dandz12/ECE411-Practicum-Project/Part_List.txt

Partlist exported from /Users/BumBum/Desktop/T09_LockBox_ver5.0.sch at 11/19/16 9:20 PM

Part  Value            Device           Package        Description			
C1    10uF             CAP0603-CAP      0603-CAP       Capacitor                                                                                                         
C2    100uF            CAP0603-CAP      0603-CAP       Capacitor                                                                                                         
C3    100uF            CAP0603-CAP      0603-CAP       Capacitor                                                                                                         
C4    0.1uF            CAP0603-CAP      0603-CAP       Capacitor                                                                                                         
C5    0.1uF            CAP0603-CAP      0603-CAP       Capacitor                                                                                                         
C6    100uF            CAP0603-CAP      0603-CAP       Capacitor                                                                                                         
D3    1N4004DO-214AC   1N4004DO-214AC   DO-214AC       DIODE                                                                                                             
J1    5.5x2.1mm Barrel POWER_JACKSMD    POWER_JACK_SMD Power Jack                                                 
J2    2Pin-Solenoid    M02PTH           1X02           Header 2                                                                             
J3    3Pin-Servo       M03PTH           1X03           Header 3                                                                                                          
J4    2Pin-Toggle      M02PTH           1X02           Header 2
J5    FEMALE 2x3       M03X2FEMALE      2X3            2x3 .1" header                                             
J6    8Pin-Keypad      M08              1X08_ROUND     Header 8                                                   
J7    7Pin-LCD-Control M07              1X07           Header 7                                                                                                          
J8    5Pin-LCD-Power   M05PTH           1X05           Header 5                                                                                                          
R3    47               RESISTOR0805-RES 0805           Resistor                                                                                                          
R4    1k               RESISTOR0603     0603-RES       Resistor                                                                                                          
R5    10k              RESISTOR0603     0603-RES       Resistor                                                                                                          
R6    8.2K             RESISTOR0603     0603-RES       Resistor                                                                                                          
R7    820              RESISTOR0603     0603-RES       Resistor                                                                                                          
R11   0                RESISTOR0603     0603-RES       Resistor                                                                                                          
R12   0                RESISTOR0603     0603-RES       Resistor                                                                                                          
R13   0                RESISTOR0603     0603-RES       Resistor                                                                                                          
T2    TIP31            TIP31            TO220          NPN Transistor                                                         
TP1   TPPAD1-13        TPPAD1-13        P1-13          Test pad                                                                                                          
TP2   TPPAD1-13        TPPAD1-13        P1-13          Test pad                                                                                                          
TP3   TPPAD1-13        TPPAD1-13        P1-13          Test pad                                                                                                          
TP4   TPPAD1-13        TPPAD1-13        P1-13 in       Test pad                                                                                                          
U1    ATMEGA328P_PDIP  ATMEGA328P_PDIP  DIL28-3        uC used in the Arduino                                                                                            
V_REG LD117AS12TR      LD117AS12TR      SOT223         Positive voltage regulators 1A
