dandz12/ECE411-Practicum-Project/T09_LockBox_Buy-web-list.rtf

0.1 uF cap
http://www.mouser.com/Passive-Components/Capacitors/_/N-5g7r?P=1yzmou6Z1z0wgtu

100 uF cap
http://www.mouser.com/ProductDetail/AVX/F980J107MMAAXE/?qs=OIhlmDO%252boa7CbJsh7hWANA%3d%3d

47 ohms res _ high power
http://www.mouser.com/Passive-Components/Resistors/_/N-5g9n?P=1z0x73sZ1yzbppyZ1yzmou0

10K ohm
http://www.mouser.com/Passive-Components/Resistors/_/N-5g9n?P=1yzmno7Z1z0x6frZ1yzmou6

1k ohm
http://www.mouser.com/Passive-Components/Resistors/Film-Resistors/Thick-Film-Resistors-SMD/_/N-7gz42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

8.2 kohm
http://www.mouser.com/Passive-Components/Resistors/Film-Resistors/Thick-Film-Resistors-SMD/_/N-7gz42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

820 ohm
http://www.mouser.com/Passive-Components/Resistors/Film-Resistors/Thick-Film-Resistors-SMD/_/N-7gz42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

barrel jack
https://www.sparkfun.com/products/12748
