dandz12/ECE411-Practicum-Project/Block Diagram for Useless Lock Box.docx

Block Diagram for Useless Lock Box

LCD

Toggle Switch

Top Door

Open/Close

Funny Thing

Front Door

Open/Close

Motor

Solenoid

KEY PAD

ATmega328P
