dandz12/ECE411-Practicum-Project/Solidworks/pictures/back.png

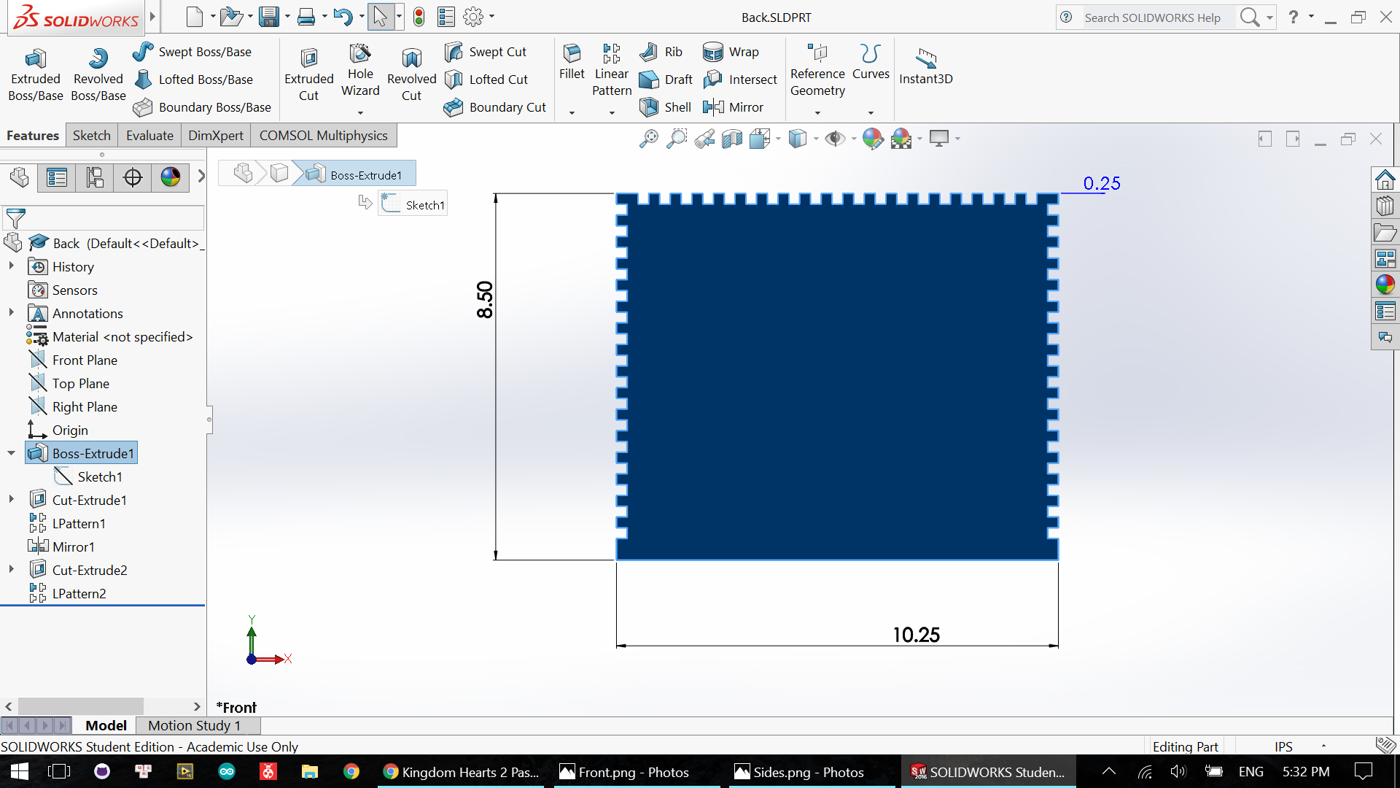
Solidworks/pictures/back.png
