dandz12/ECE411-Practicum-Project/Solidworks/pictures/Bottom.png

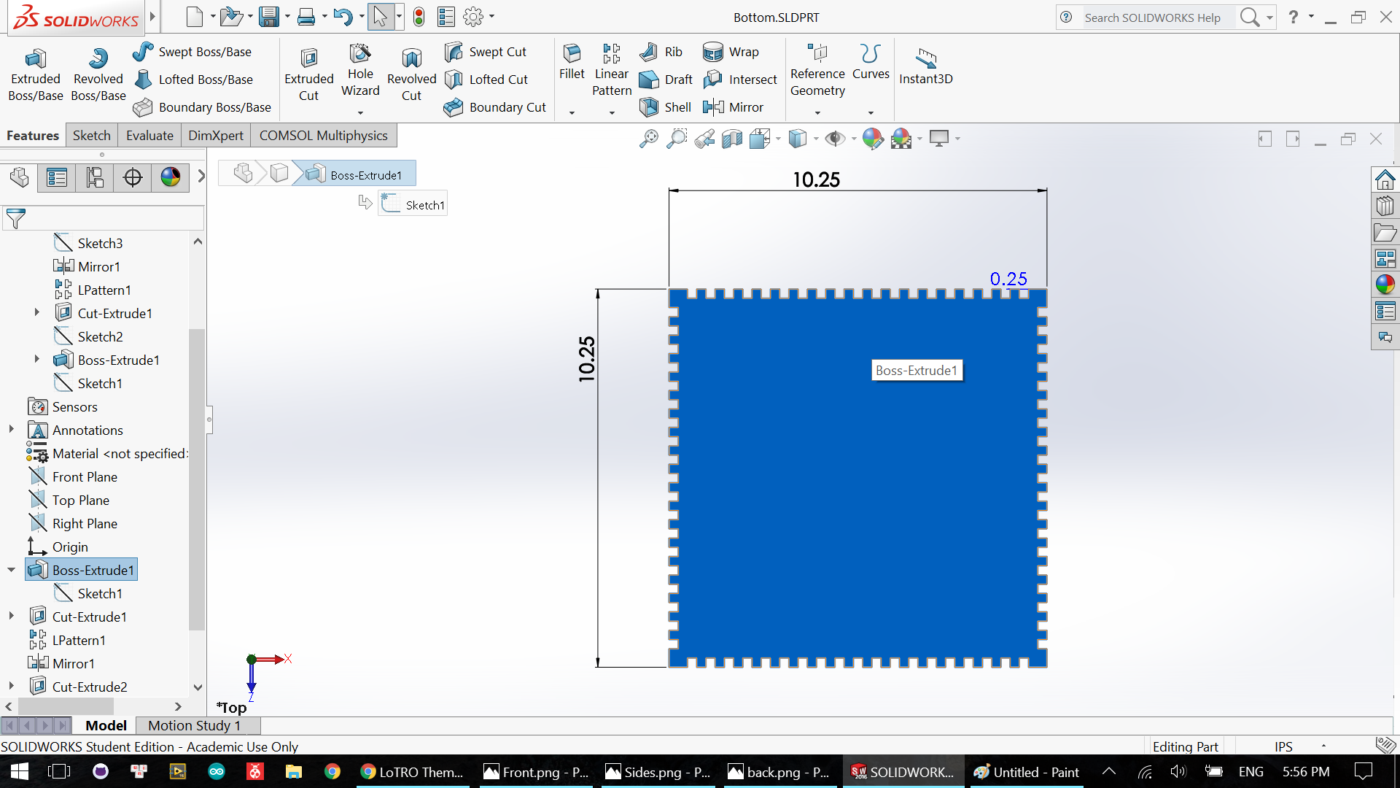
Solidworks/pictures/Bottom.png
