dandz12/ECE411-Practicum-Project/Solidworks/pictures/Front.png

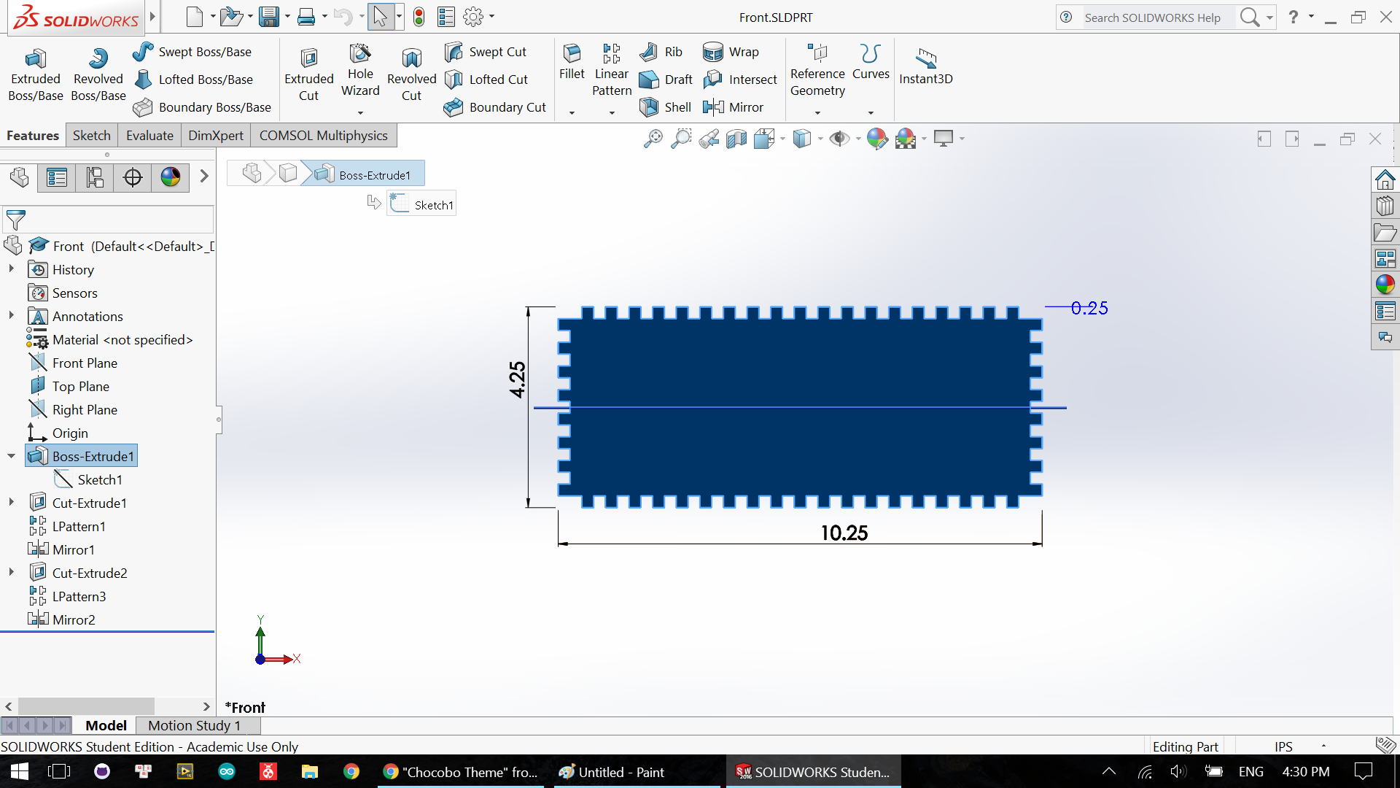
Solidworks/pictures/Front.png
