dandz12/ECE411-Practicum-Project/Solidworks/pictures/full box.png

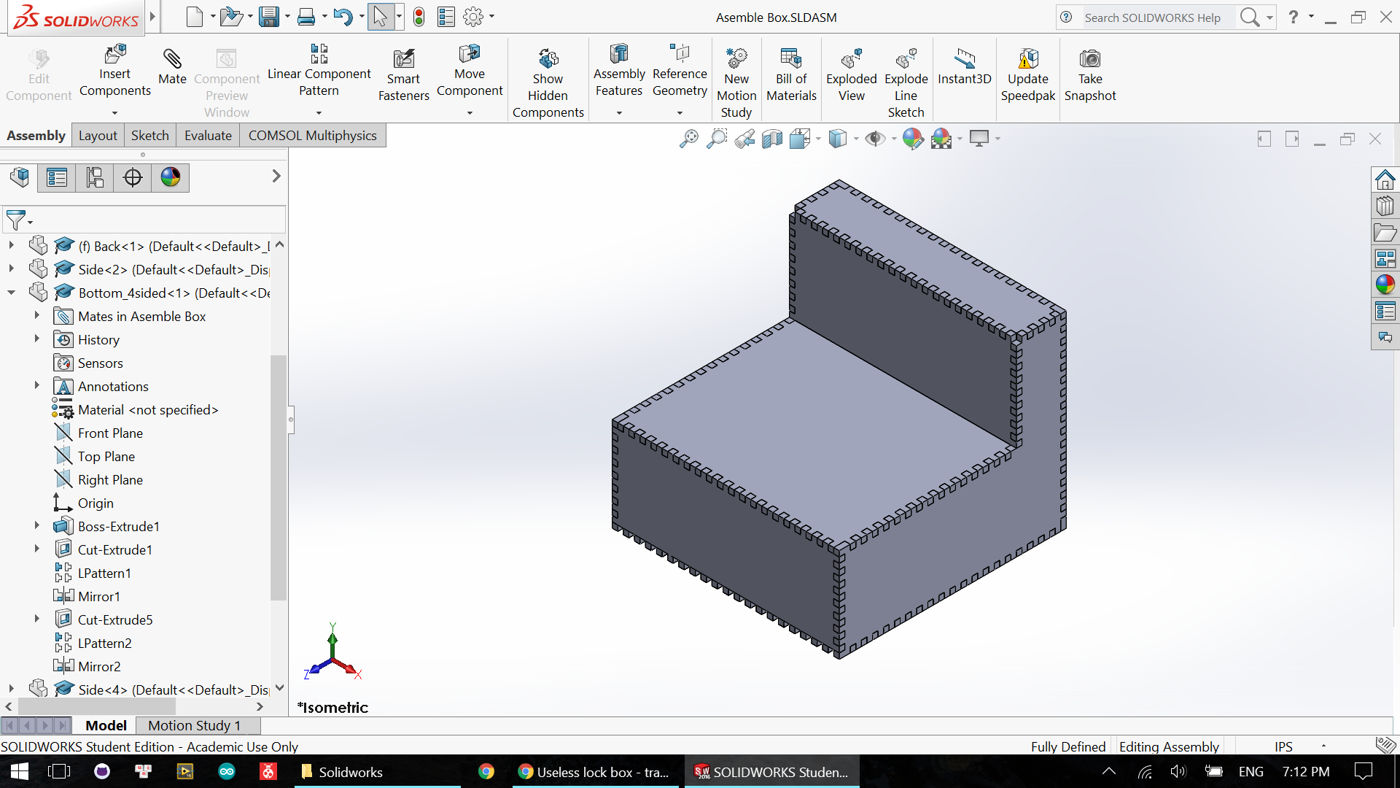
Solidworks/pictures/full box.png
