dandz12/ECE411-Practicum-Project/Solidworks/pictures/Sides.png

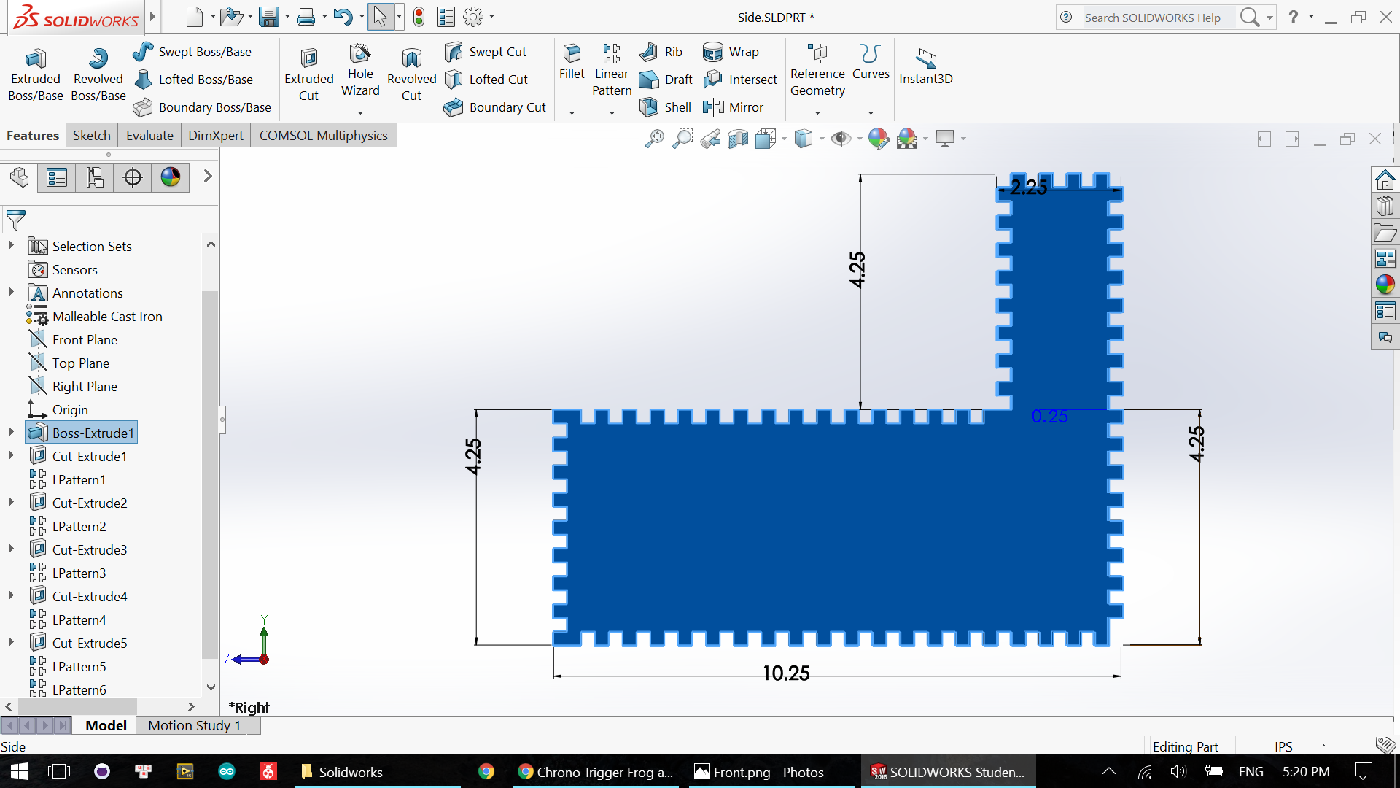
Solidworks/pictures/Sides.png
