dandz12/ECE411-Practicum-Project/Total Unit Cost.xlsx

Part | Value/Name | Quantity | Unit Price (USD) | Column1
Capacitors (SMD) | 0.1 𝜇F | 2 | 0.230 | 0.460
 | 10 𝜇F | 1 | 0.250 | 0.250
 | 100 𝜇F | 3 | 0.382 | 1.146
Resistors (SMD) | 0 𝛺 | 3 | 0.100 | 0.300
 | 47 𝛺 | 1 | 0.058 | 0.058
 | 820 𝛺 | 1 | 0.071 | 0.071
 | 1 k𝛺 | 1 | 0.071 | 0.071
 | 8.2 k𝛺 | 1 | 0.071 | 0.071
 | 10 k𝛺 | 1 | 0.071 | 0.071
NPN Transistor | Tip31 | 1 | 2.000 | 2.000
Diode (SMD) | 1N4004 | 1 | 0.100 | 0.100
Voltage Regulator (SMD) | AMS-1117 | 1 | 0.613 | 0.613
Power Jack (SMD) | 5.5x2.1mm | 1 | 1.500 | 1.500
Microprocessor | ATmega328P | 1 | 5.000 | 5.000
Header |  | 25 | 0.001 | 0.025
Jumper Wire |  | 25 | 0.001 | 0.025
Switch | Rocker Toggle | 1 | 0.742 | 0.742
Solenoid | 4.5V - 0.375A | 1 | 1.998 | 1.998
Keypad | 4x4 matrix | 1 | 3.975 | 3.975
LCD | 16x2 LCD | 1 | 5.900 | 5.900
Servo | TowerPro SG90 | 1 | 2.500 | 2.500
Battery | 9V | 1 | 3.000 | 3.000
Battery holders |  | 2 | 0.995 | 1.990
Battery connector |  | 1 | 0.398 | 0.398
PCB Printing |  | 1 | 10.250 | 10.250
Bamboo Plywood |  | 3 | 10.000 | 30.000
Laser Cutting |  | 1 | 5.000 | 5.000
Metal Sheet |  | 1 | 0.630 | 0.630
Hinges |  | 3 | 0.250 | 0.750
 |  | Total Box Unit Coss |  | 78.893
