dandz12/ECE411-Practicum-Project/Decision Matrix.xlsx

Student | Project Proposal | Sensors |  | Soldering Difficulty | Actuators |  | Soldering Difficulty | Price | Size | Creative | Complexity | Total
Daniel | Sequence controlled alarm clock | 1 | Buttons | 3 | 1 | LCD Screen | 3 | 3 | 3 | 1 | 2 | 19
 |  | 2 |  |  | 2 | Speaker | 2
 |  | 3 |  |  | 3
Dwayne | Personal CO2 detector | 1 | C02 sensor | 5 | 1 | Alarm/Buzzer | 1 | 3 | 2 | 3 | 4 | 36
 |  | 2 |  |  | 2 | Display | 3
 |  | 3 |  |  | 3
Ha | Rain alarm system | 1 | Humidity sensor | 4 | 1 | LCD Screen | 3 | 3 | 3 | 2 | 3 | 25
 |  | 2 | Temperature sensor | 4 | 2 | Alarm | 1
 |  | 3 |  |  | 3
Thanh | Useless Lock Box | 1 | Number Pad Buttons | 3 | 1 | LCD Screen | 3 | 3 | 4 | 4 | 3 | 39
 |  | 2 |  |  | 2 | Speaker | 2
 |  | 3 |  |  | 3 | Motors | 2
 |  |  | Scale: | Easy-Difficult |  |  | Easy-Difficult | Cheap-Expensive | Small-Large | Not-Very | Not-Very
 |  |  | Weight: | 1 |  |  | 1 | 2 | 2 | 5 | 5
