dandz12/ECE411-Practicum-Project/Box Solidwork/LockBox.SLDASM

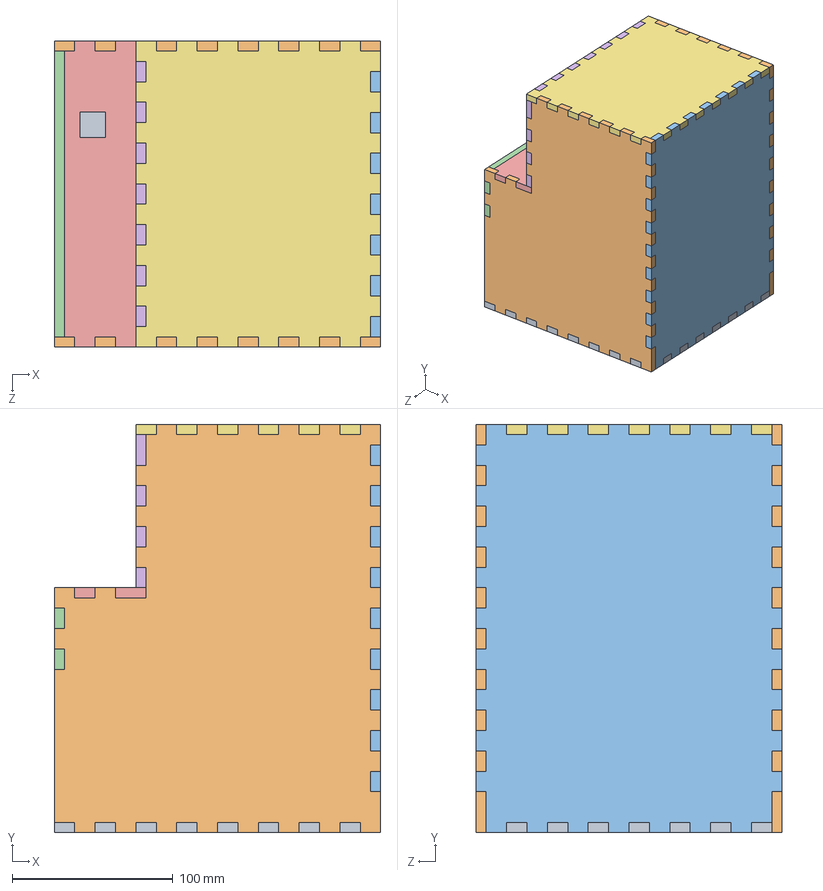
[picture p26: CAD file, 2016-12-08]
Box Solidwork/LockBox.SLDASM
203.2 x 254.0 x 190.5 mm
Bottom
Side x 2
Back
Front1
Top1
Front2
Top2
Door
