dandz12/ECE411-Practicum-Project/Solidworks/Asemble Box.SLDASM

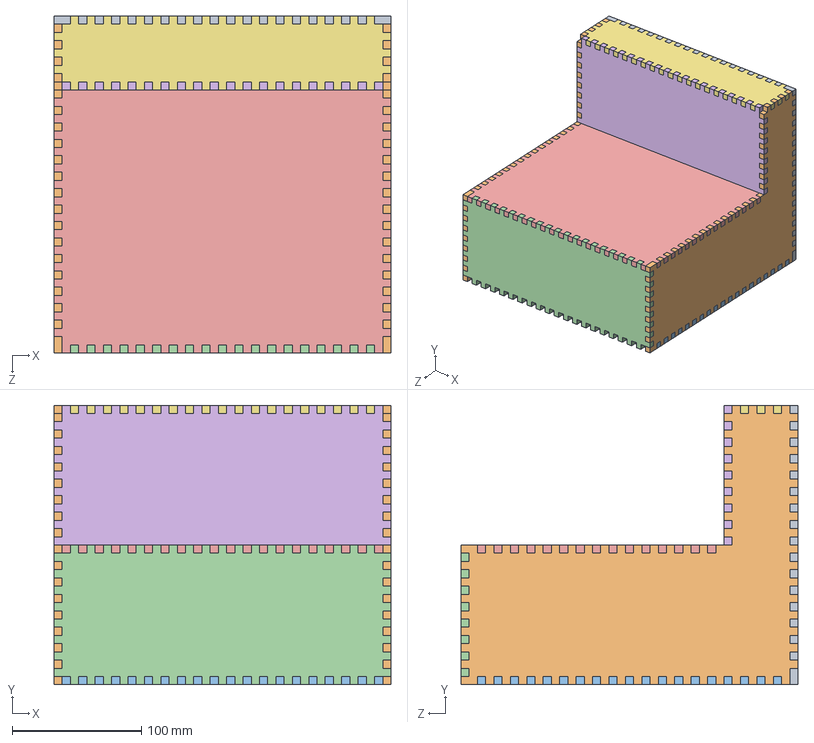
[picture p27: CAD file, 2016-11-25]
Solidworks/Asemble Box.SLDASM
260.4 x 215.9 x 260.4 mm
Back
Side x 2
Bottom_4sided
Front
Top_big
Front_topversion
Top-small
