dandz12/ECE411-Practicum-Project/Box Solidwork/Top2.SLDPRT

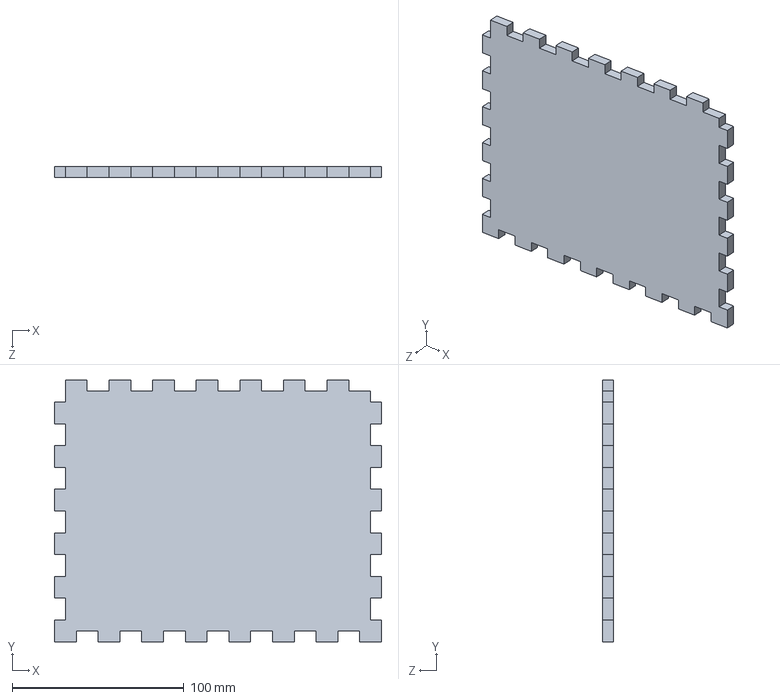
[picture p28: CAD file, 2016-12-08]
Box Solidwork/Top2.SLDPRT
190.5 x 152.4 x 6.35 mm
