dandz12/ECE411-Practicum-Project/Solidworks/Back.SLDPRT

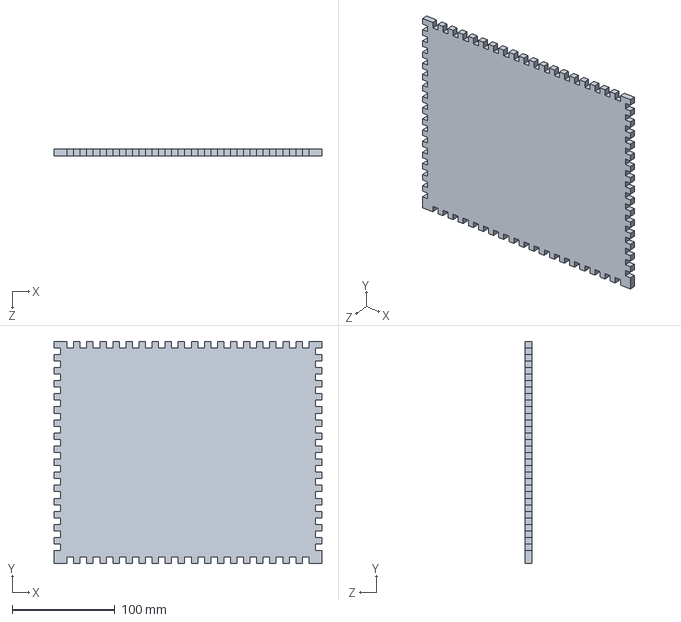
[picture p29: CAD file, 2016-11-25]
Solidworks/Back.SLDPRT
260.3 x 215.9 x 6.35 mm
