dandz12/ECE411-Practicum-Project/Box Solidwork/Front2.SLDPRT

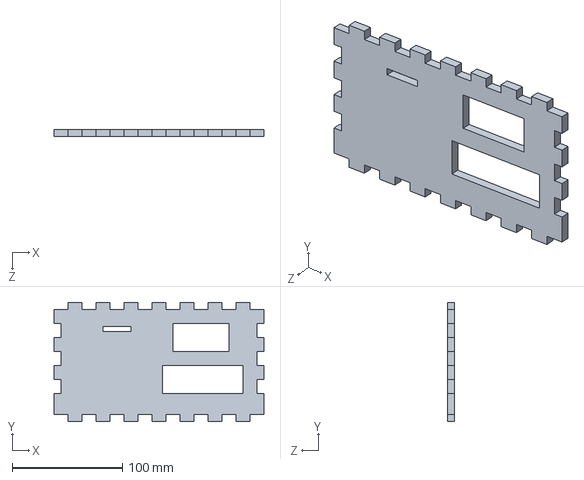
[picture p30: CAD file, 2016-12-08]
Box Solidwork/Front2.SLDPRT
190.5 x 108.0 x 6.35 mm
