dandz12/ECE411-Practicum-Project/Solidworks/Front.SLDPRT

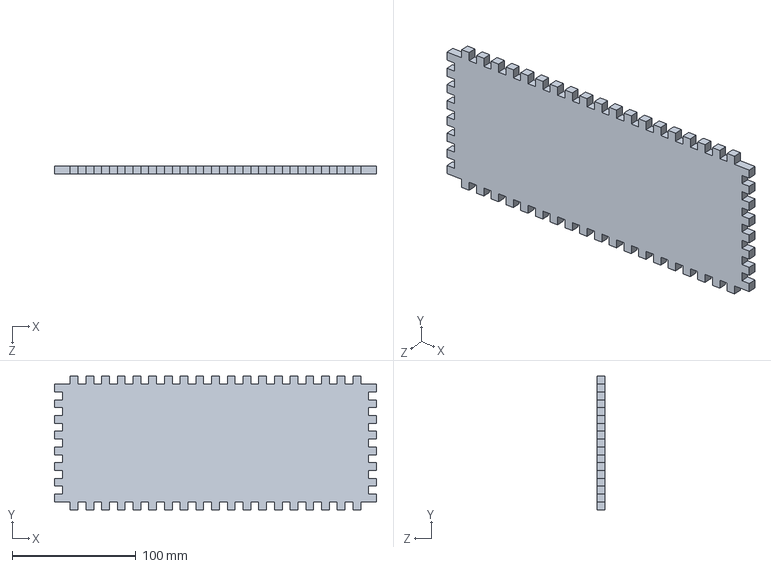
[picture p31: CAD file, 2016-11-25]
Solidworks/Front.SLDPRT
260.3 x 108.0 x 6.35 mm
