dandz12/ECE411-Practicum-Project/Box Solidwork/Back.SLDPRT

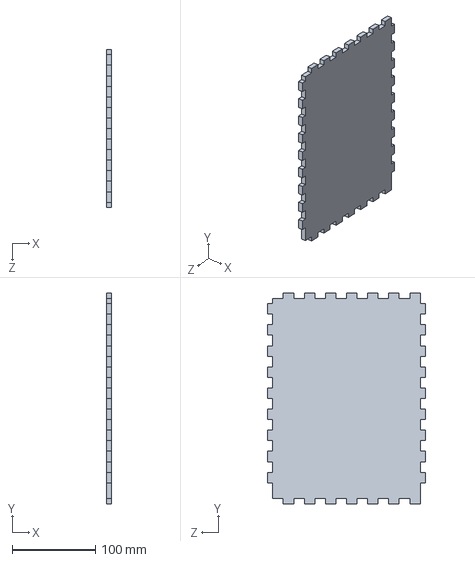
[picture p32: CAD file, 2016-12-08]
Box Solidwork/Back.SLDPRT
6.35 x 254.0 x 190.5 mm
