dandz12/ECE411-Practicum-Project/Solidworks/Top-small.SLDPRT

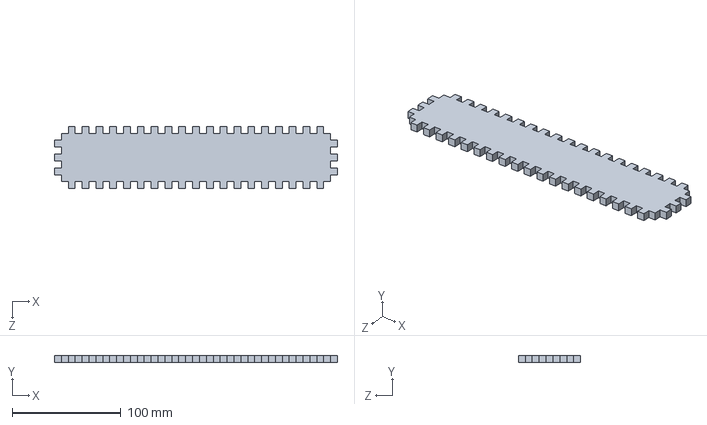
[picture p33: CAD file, 2016-11-25]
Solidworks/Top-small.SLDPRT
260.3 x 6.35 x 57.1 mm
