dandz12/ECE411-Practicum-Project/Box Solidwork/Door.SLDPRT

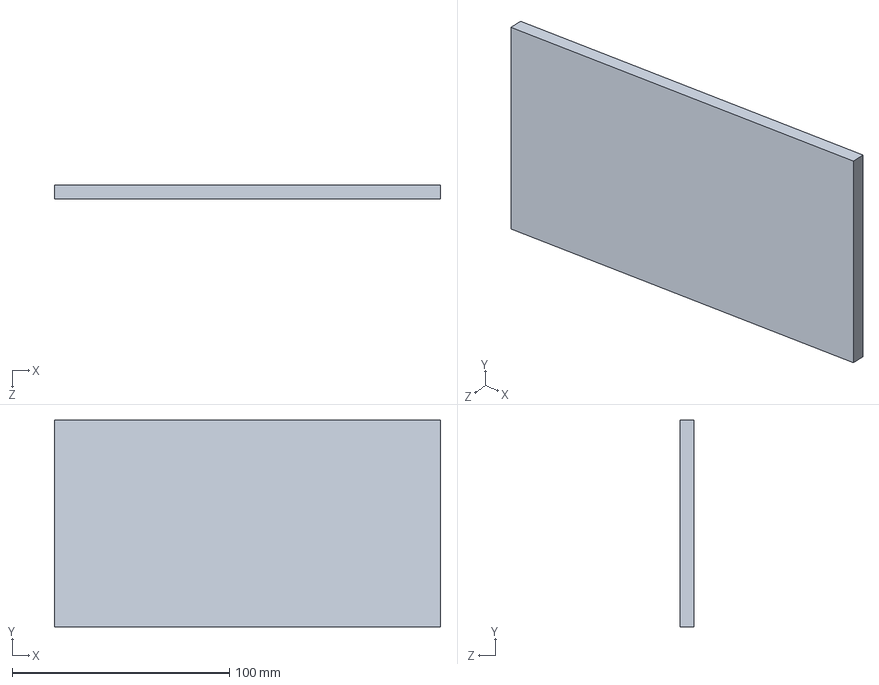
[picture p34: CAD file, 2016-12-08]
Box Solidwork/Door.SLDPRT
177.8 x 95.2 x 6.35 mm
