dandz12/ECE411-Practicum-Project/Solidworks/Front_topversion.SLDPRT

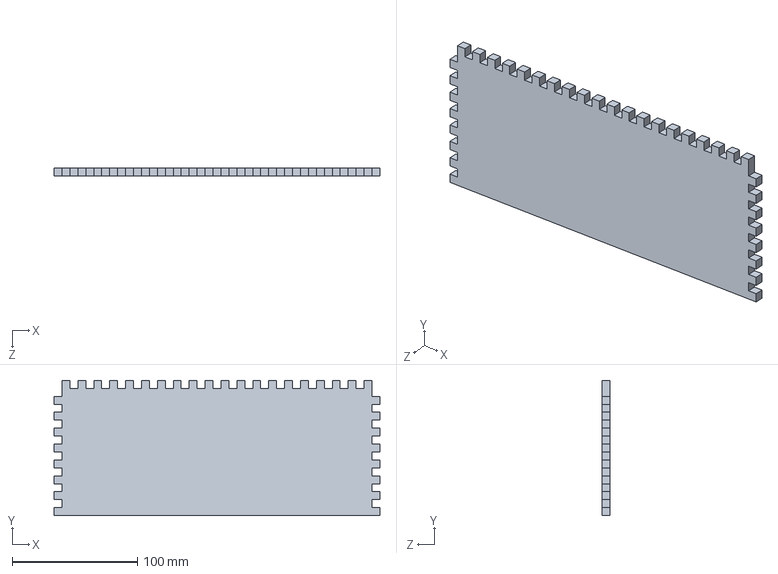
[picture p35: CAD file, 2016-11-25]
Solidworks/Front_topversion.SLDPRT
260.3 x 108.0 x 6.35 mm
