dandz12/ECE411-Practicum-Project/Solidworks/Side.SLDPRT

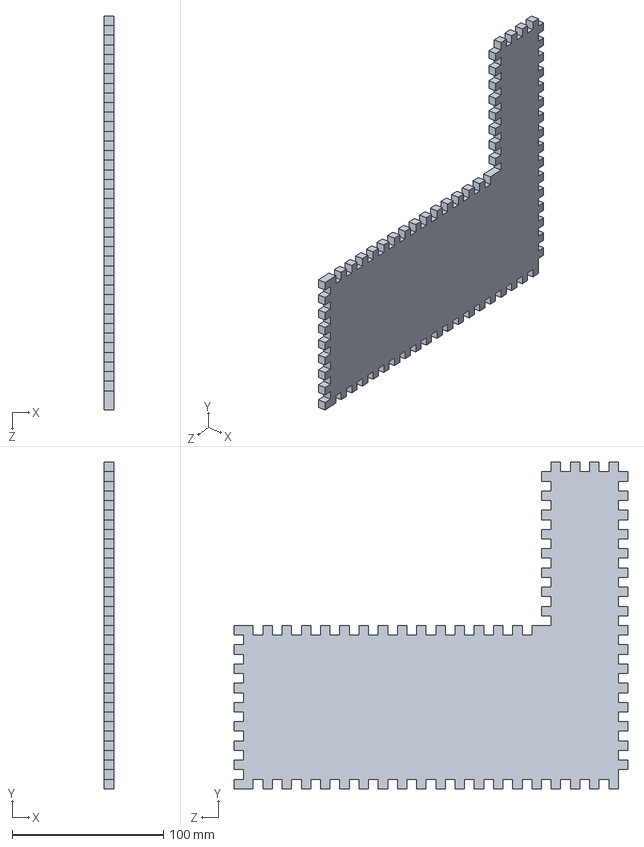
[picture p36: CAD file, 2016-11-25]
Solidworks/Side.SLDPRT
6.35 x 215.9 x 260.3 mm
