dandz12/ECE411-Practicum-Project/Solidworks/Bottom.SLDPRT

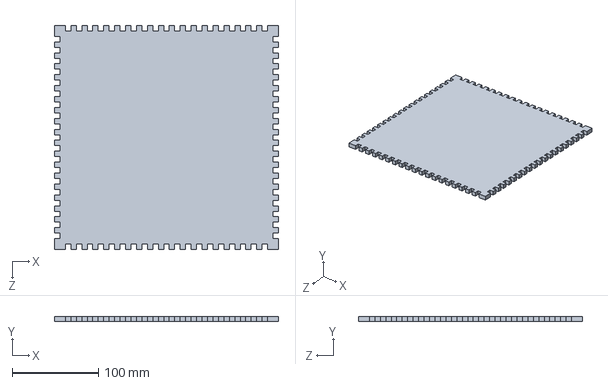
[picture p38: CAD file, 2016-11-25]
Solidworks/Bottom.SLDPRT
260.3 x 6.35 x 260.3 mm
