dandz12/ECE411-Practicum-Project/Solidworks/Top_big.SLDPRT

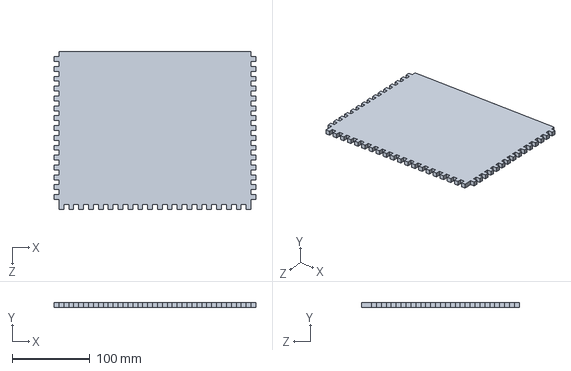
[picture p39: CAD file, 2016-11-25]
Solidworks/Top_big.SLDPRT
260.3 x 6.35 x 203.2 mm
