dandz12/ECE411-Practicum-Project/Box Solidwork/Side.SLDPRT

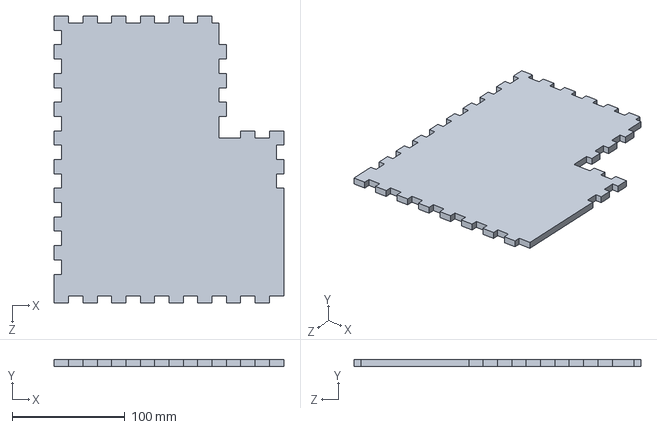
[picture p40: CAD file, 2016-12-08]
Box Solidwork/Side.SLDPRT
203.2 x 6.35 x 254.0 mm
