dandz12/ECE411-Practicum-Project/Box Solidwork/Bottom.SLDPRT

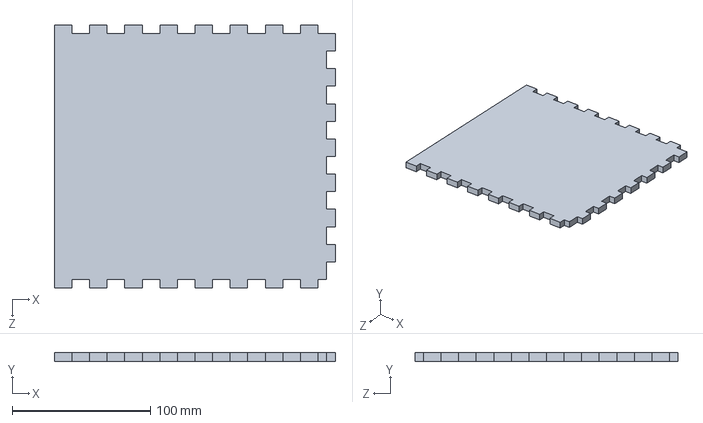
[picture p41: CAD file, 2016-12-08]
Box Solidwork/Bottom.SLDPRT
203.2 x 6.35 x 190.5 mm
