dandz12/ECE411-Practicum-Project/Box Solidwork/Front1.SLDPRT

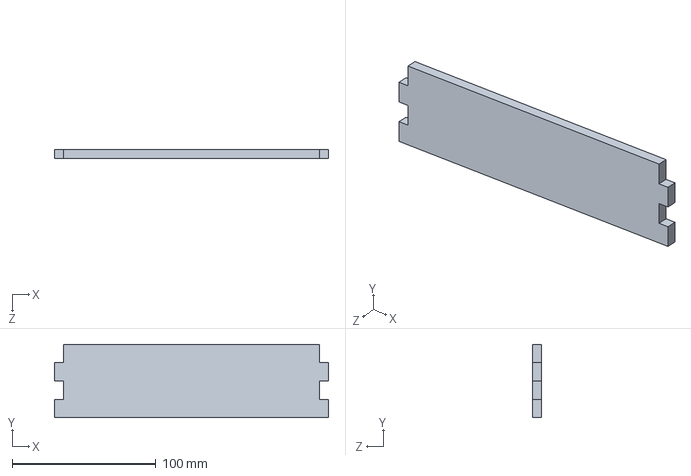
[picture p42: CAD file, 2016-12-08]
Box Solidwork/Front1.SLDPRT
190.5 x 50.8 x 6.35 mm
