dandz12/ECE411-Practicum-Project/(list of files, cad)

Other CAD files:
Solidworks/Bottom_4sided.SLDPRT
Box Solidwork/Bottom_Top2_Door.SLDDRW
Box Solidwork/Side_Back.SLDDRW
Box Solidwork/Side_Front1-2_Top1.SLDDRW
Box Solidwork/Top1 - Copy.SLDPRT
