dandz12/ECE411-Practicum-Project/Test Plan.docx

Team 09 – Useless Lock Box

Test Plan

Rev 1.0

11-24-2016

REVISION HISTORY

Date | Version | Description | Author
11/21/2016 | 1.0 | Initial release | Team 9
11/24/2016 | 2.0 | Test Plan Revision Meeting | Team 9

# 1. Objective

This document describes the test plan for the Useless Lock Box, Team 09’s practicum project in ECE411. This test plan document supports the following objectives:

- Identify project information about what should be tested.
- List of the recommended test equipment
- Identify the required human resources
- Provide an estimate of the test efforts

# 2. Design documentation (see appendix)

  2.1. Description, Rev 1.0
  2.2. PDS – Product Design Specification, Rev 2.0
  2.3. Block Diagram, Rev 2.0
  2.4. Schematic, Rev 5.0
  2.5. Board Layout, Rev 5.0
  2.6. BOM – Bill of Materials

# 3. Test Equipment

  3.1. Computer
  3.2. AVR Dragon or other development board
  3.3. Power Supply
  3.4. VOM – Volt Ohm Meter
  3.5. Oscilloscope
  3.6. 2 prototypes of the Useless Lock Box

# 4. Human resources

The test team consists of 4 members. A member must be a senior student majoring in Electrical Engineering. Expected time length is 1.5 weeks (10 hours per weeks) for each team member.

Below is the detail staffing. Notice that each member should collaborate which others to fully understand test plan as a ECE411’s deliverable.

Role | HR | Responsibility
Test manager | Dwayne | Provide direction for the team Manage reports
Implementer | Thanh | Create/build necessary test unit
Code tester | Daniel | Test code for microcontroller
Mechanical tester | Ha | Test toggle switch and lock mechanism

# 5. System Tests

  5.1. Unit/Module Tests

A complete test of a module’s functionality to ensure desired results.

    5.1.1. Servo
    5.1.2. Keypad
    5.1.3. Solenoid
    5.1.4. LCD Screen
    5.1.5. Switch
  5.2. Integration Tests

Complete testing of paths between modules to ensure they operate correctly together.

    5.2.1. Possible system paths
      5.2.1.1. Switch to LCD
      5.2.1.2. LCD to Keypad
      5.2.1.3. Correct Code Entered
        5.2.1.3.1. Keypad to Solenoid
        5.2.1.3.2. Keypad to Servo
        5.2.1.3.3. Servo to LCD
      5.2.1.4. Administration Code Entered
        5.2.1.4.1. Keypad to LCD
        5.2.1.4.2. LCD to Keypad
        5.2.1.4.3. Keypad to Servo
        5.2.1.4.4. Servo to LCD
      5.2.1.5. Incorrect Code Entered
        5.2.1.5.1. Keypad to Servo
        5.2.1.5.2. Servo to LCD
  5.3. Acceptance Test – Appendix A

Check to ensure the end result meets the conditions the customer defined in the PDS.

    5.3.1. Functionality
    5.3.2. Economic Goals
    5.3.3. Aesthetics
    5.3.4. Operational Physical Environment
    5.3.5. Size/Weight
  5.4. Stress Tests

Check behavior when extreme circumstances arise.

    5.4.1. Power Removed
    5.4.2. See User Error Tests
  5.5. Use Testing

Check typical user interaction.

    5.5.1. Flip Switch
      5.5.1.1. Correct Code
      5.5.1.2. Administration Code
      5.5.1.3. Incorrect Code
  5.6. Error Testing

Test for error conditions originating from non-prescribed user behavior and system bugs.

    5.6.1. User Error
      5.6.1.1. Double Key Press
      5.6.1.2. Obstruction of Arm Path
      5.6.1.3. Quick On Then Off of Switch
      5.6.1.4. 4 + n Keys Pressed
      5.6.1.5. 4 – n Keys Pressed
    5.6.2. System Errors
      5.6.2.1. LCD Timing
      5.6.2.2. PWM Timing
      5.6.2.3. Switch Doesn’t Get Flipped

# 6. Appendix A

Design documentation can be found at: https://github.com/dandz12/ECE411-Practicum-Project

Test Cases
