dandz12/ECE411-Practicum-Project/Box Files For Laser Cutting/Bottom_Top2_Door.PDF

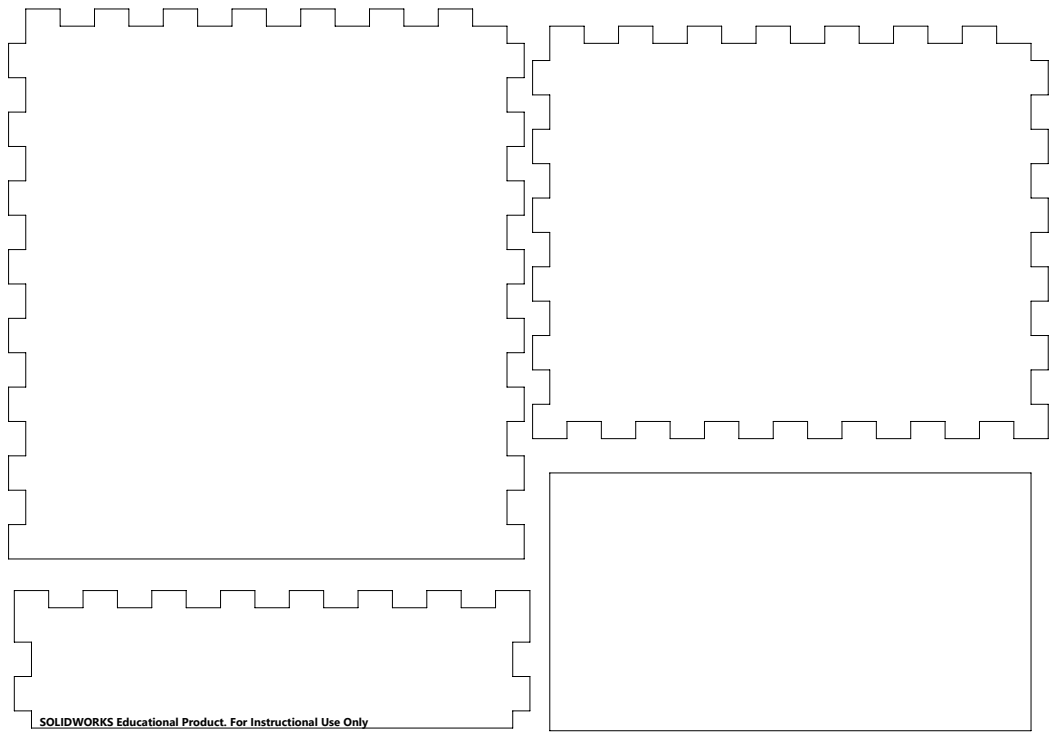
[picture p43: page 1]

SOLIDWORKS Educational Product. For Instructional Use Only
