dandz12/ECE411-Practicum-Project/Box Files For Laser Cutting/Side_Back.PDF

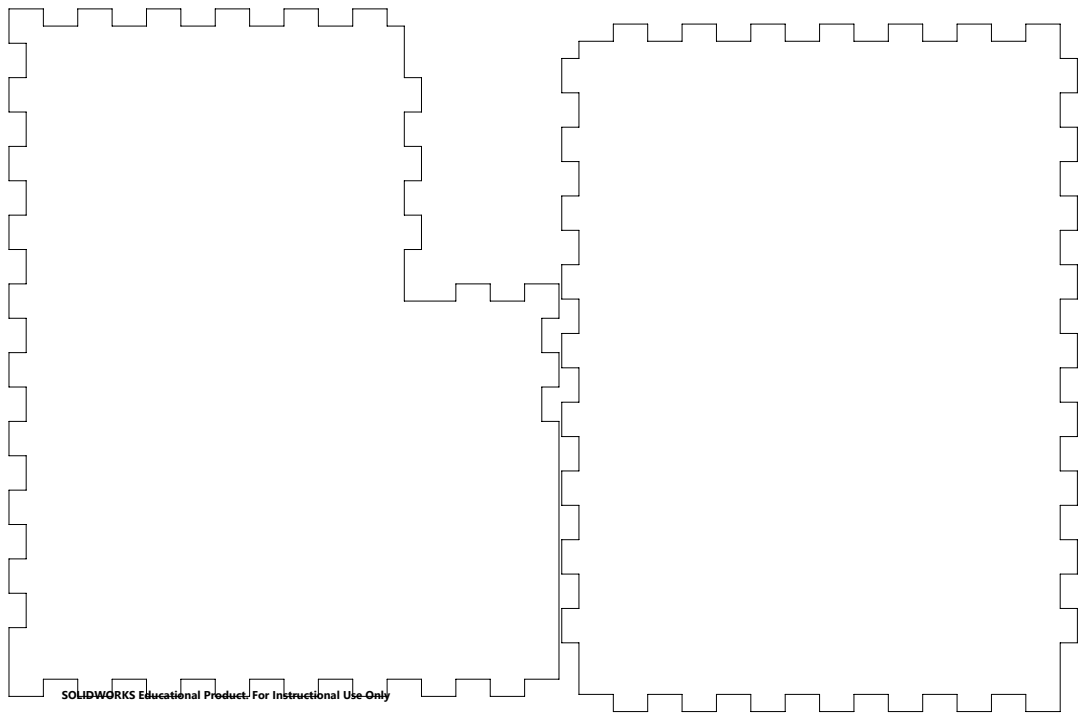
[picture p44: page 1]

SOLIDWORKS Educational Product. For Instructional Use Only
