dandz12/ECE411-Practicum-Project/Box Files For Laser Cutting/Side_Front1-2_Top1.PDF

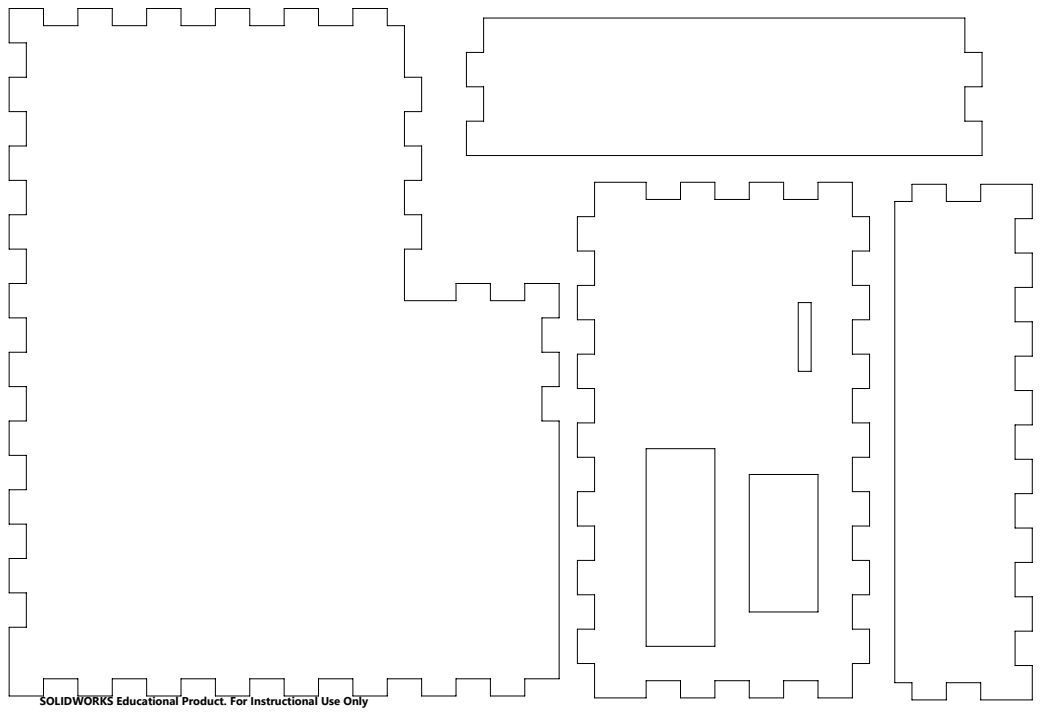
[picture p45: page 1]

SOLIDWORKS Educational Product. For Instructional Use Only
