dandz12/ECE411-Practicum-Project/T09_LockBox_ver5.0.brd

## EAGLE design T09_LockBox_ver5.0.brd (2016-11-17)

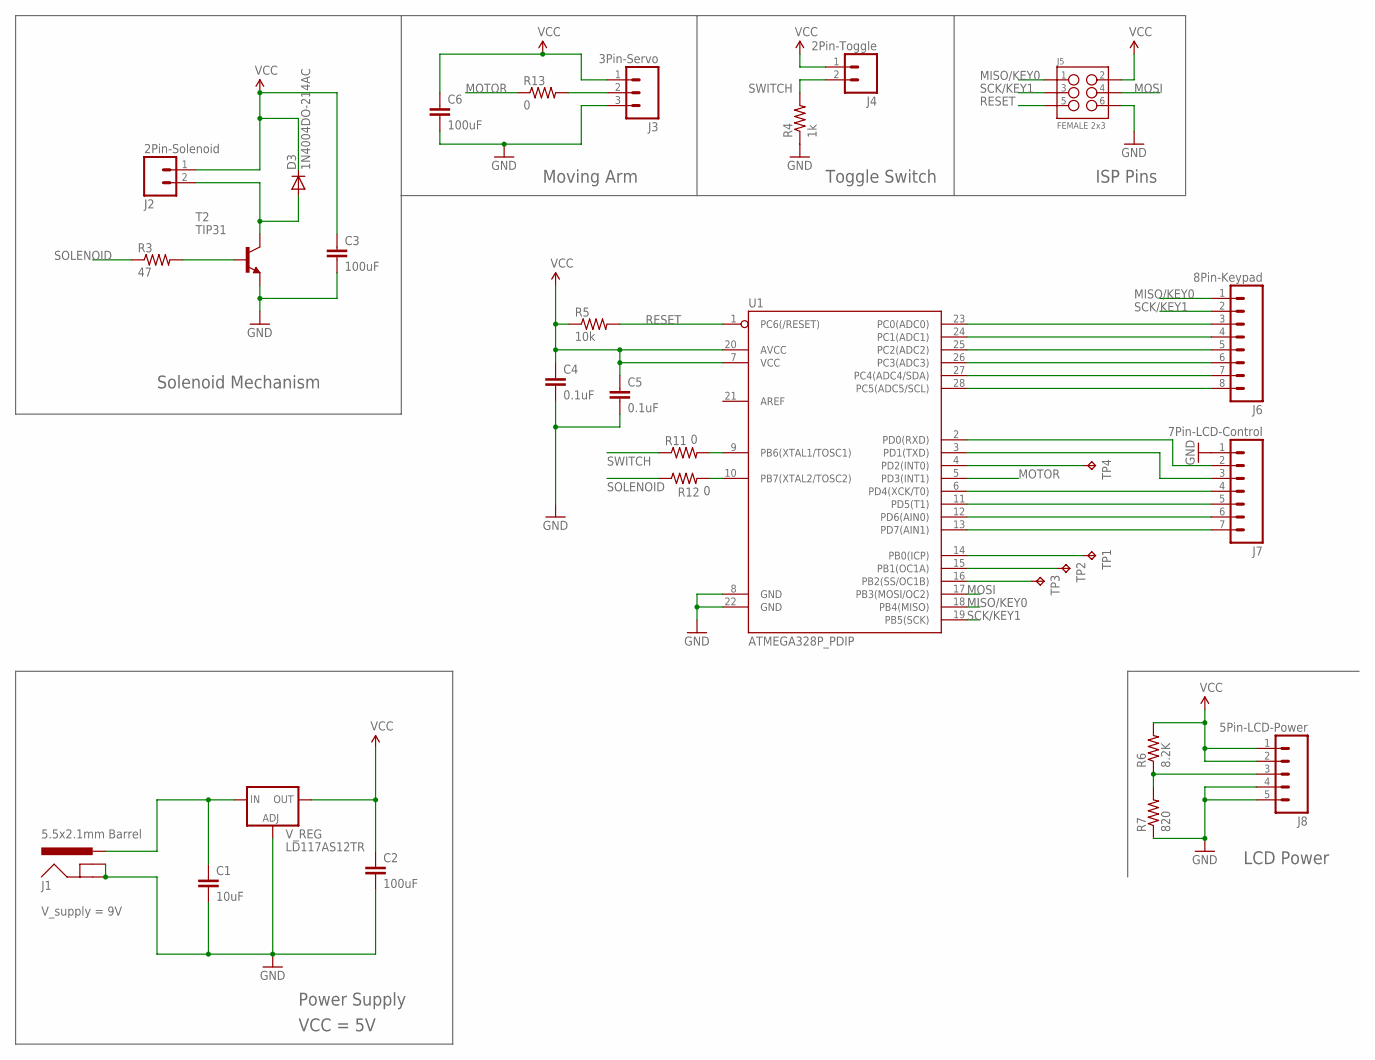
[picture p46: schematic T09_LockBox_ver5.0.sch]

Parts:
C1: 10uF; 0603-CAP
C2, C3, C6: 100uF; 0603-CAP
C4, C5: 0.1uF; 0603-CAP
D3: 1N4004DO-214AC; DO-214AC
J1: 5.5x2.1mm Barrel; POWER_JACK_SMD
J2: 2Pin-Solenoid; 1X02
J3: 3Pin-Servo; 1X03
J4: 2Pin-Toggle; 1X02
J5: FEMALE 2x3; 2X3
J6: 8Pin-Keypad; 1X08_ROUND
J7: 7Pin-LCD-Control; 1X07
J8: 5Pin-LCD-Power; 1X05
R3: 47; 0805
R4: 1k; 0603-RES
R5: 10k; 0603-RES
R6: 8.2K; 0603-RES
R7: 820; 0603-RES
R11, R12, R13: 0; 0603-RES
T2: TIP31; TO220
TP1, TP2, TP3, TP4: TPPAD1-13; P1-13
U1: ATMEGA328P_PDIP; DIL28-3
V_REG: LD117AS12TR; SOT223

Connections:
GND: C1.2, C2.2, C3.2, C4.2, C5.2, C6.2, J1.GND (GNDBREAK), J1.P$4 (GND), J3.3, J5.6, J7.1, J8.4, J8.5, R4.1, R7.1, T2.3 (E), U1.8 (GND), U1.22 (GND), V_REG.1 (ADJ)
MISO/KEY0: J5.1, J6.1, U1.18 (PB4(MISO))
MOSI: J5.4, U1.17 (PB3(MOSI/OC2))
MOTOR: R13.1, U1.5 (PD3(INT1))
unnamed: D3.A, J2.2, T2.2 (C)
unnamed: J8.3, R6.1, R7.2
unnamed: R3.2, T2.1 (B)
unnamed: J7.2, U1.2 (PD0(RXD))
unnamed: R11.2, U1.9 (PB6(XTAL1/TOSC1))
unnamed: R12.2, U1.10 (PB7(XTAL2/TOSC2))
unnamed: J3.2, R13.2
unnamed: J7.3, U1.3 (PD1(TXD))
unnamed: J7.4, U1.6 (PD4(XCK/T0))
unnamed: J7.5, U1.11 (PD5(T1))
unnamed: J7.6, U1.12 (PD6(AIN0))
unnamed: J7.7, U1.13 (PD7(AIN1))
unnamed: J6.3, U1.23 (PC0(ADC0))
unnamed: J6.4, U1.24 (PC1(ADC1))
unnamed: J6.5, U1.25 (PC2(ADC2))
unnamed: J6.6, U1.26 (PC3(ADC3))
unnamed: J6.7, U1.27 (PC4(ADC4/SDA))
unnamed: J6.8, U1.28 (PC5(ADC5/SCL))
unnamed: TP4.TP, U1.4 (PD2(INT0))
unnamed: TP1.TP, U1.14 (PB0(ICP))
unnamed: TP2.TP, U1.15 (PB1(OC1A))
unnamed: TP3.TP, U1.16 (PB2(SS/OC1B))
RESET: J5.5, R5.2, U1.1 (PC6(/RESET))
SCK/KEY1: J5.3, J6.2, U1.19 (PB5(SCK))
SOLENOID: R3.1, R12.1
SWITCH: J4.2, R4.2, R11.1
VCC: C2.1, C3.1, C4.1, C5.1, C6.1, D3.C, J2.1, J3.1, J4.1, J5.2, J8.1, J8.2, R5.1, R6.2, U1.7 (VCC), U1.20 (AVCC), V_REG.4 (OUT)
VIN: C1.1, J1.VIN0 (PWR), V_REG.3 (IN)

Notes on the sheet:
VCC = 5V
Solenoid Mechanism
Moving Arm
ISP Pins
Toggle Switch
Power Supply
LCD Power
V_supply = 9V

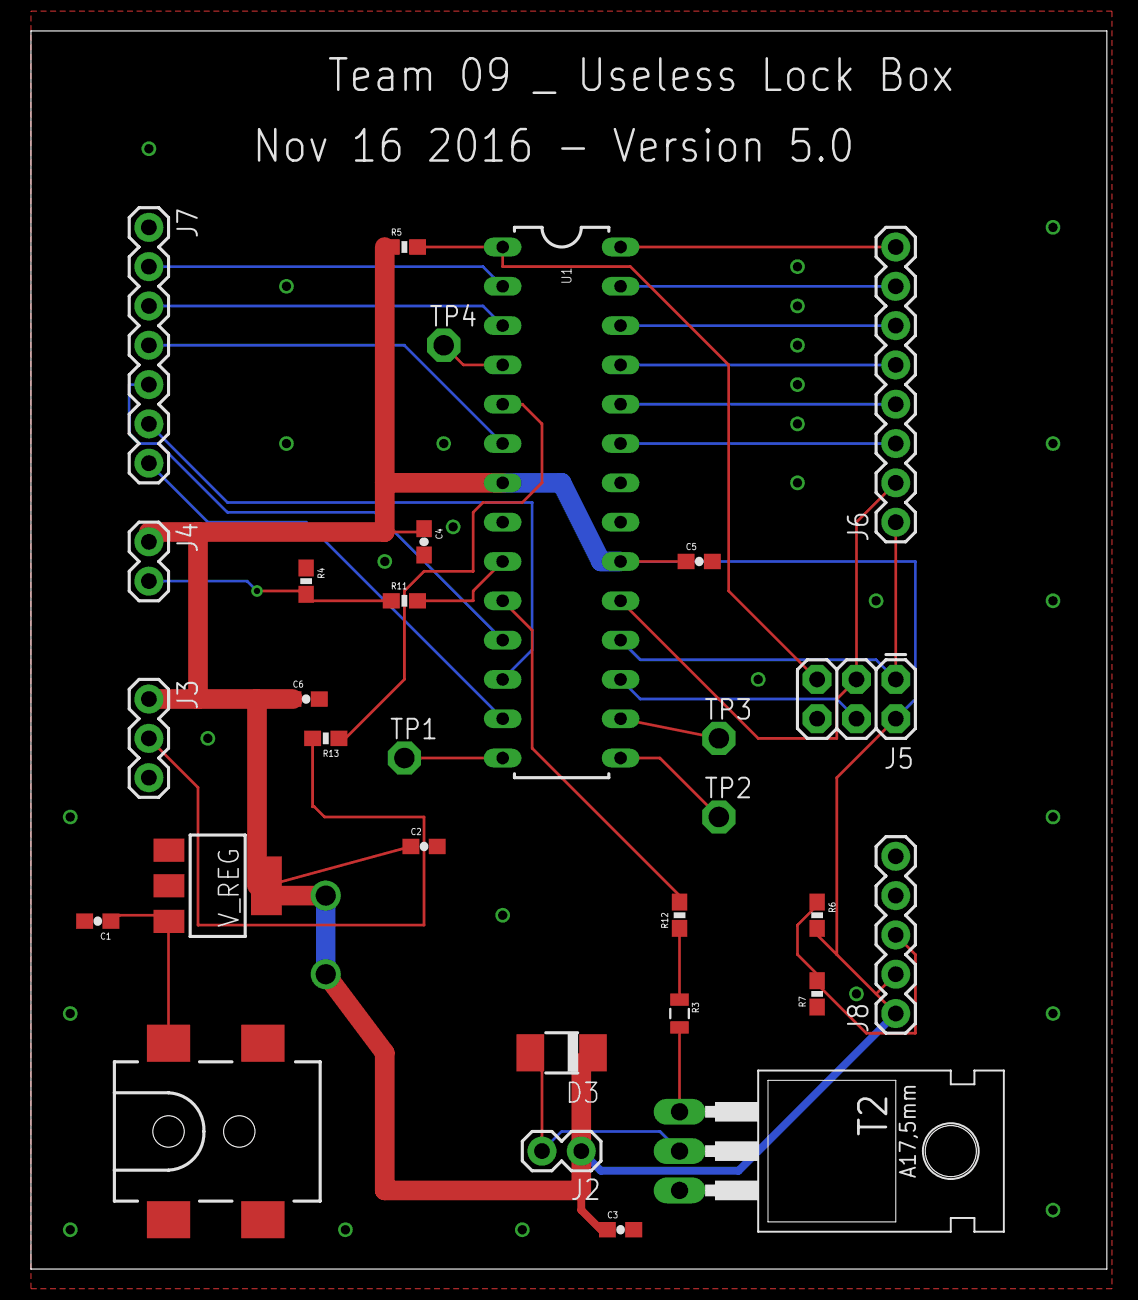
[picture p47: board T09_LockBox_ver5.0.brd from above]

Board: 2 copper layers, 69.5 x 80.0 mm, 30 parts (0 on the bottom side), 32 nets.
