dandz12/ECE411-Practicum-Project/T09_LockBox_ver4.brd

## EAGLE design T09_LockBox_ver4.brd (2016-11-10, an earlier design)

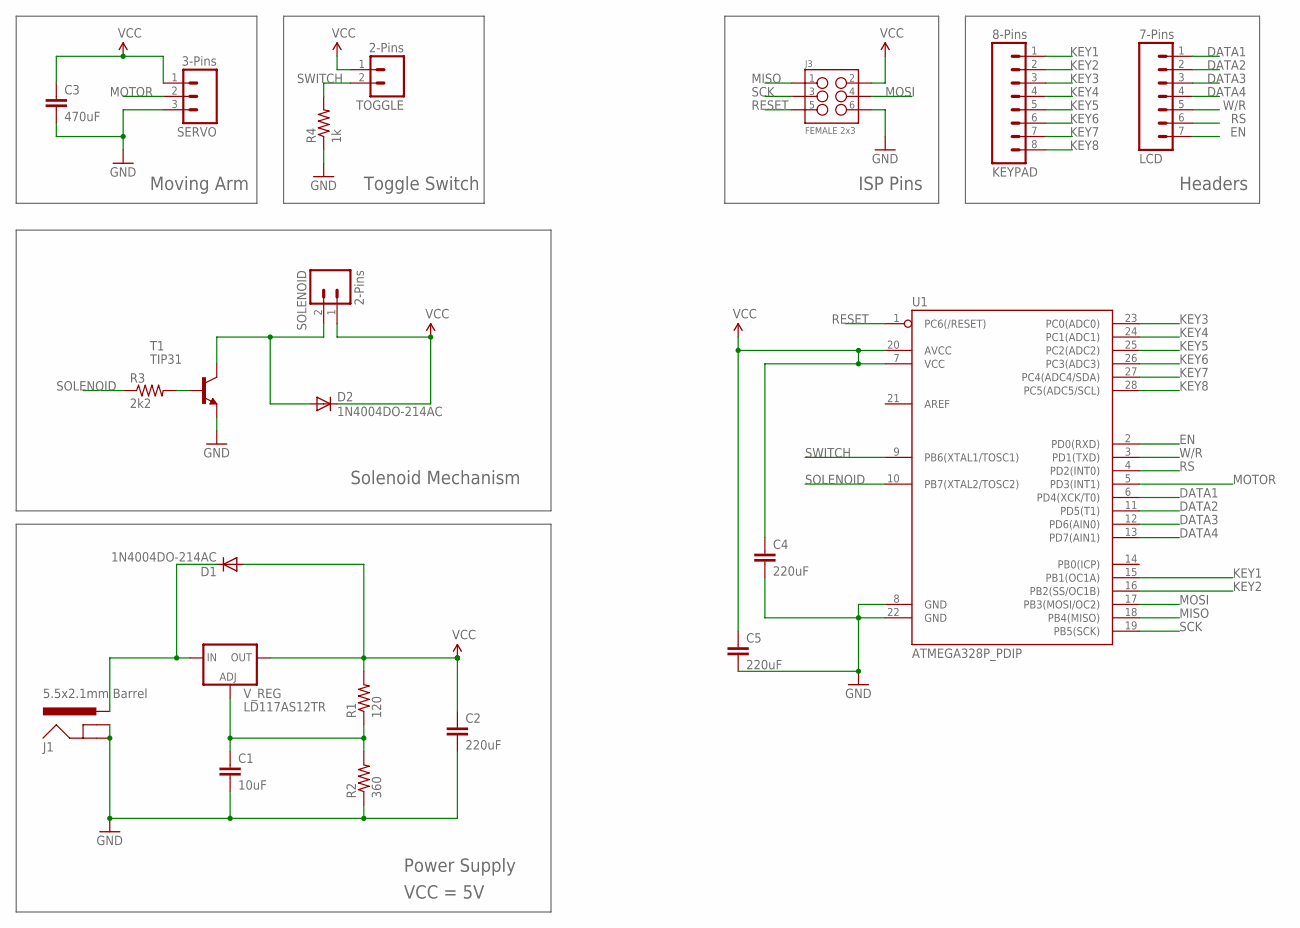
[picture p48: schematic T09_LockBox_ver4.sch]

Parts:
C1: 10uF; 0603-CAP
C2, C4, C5: 220uF; 0603-CAP
C3: 470uF; 0603-CAP
D1, D2: 1N4004DO-214AC; DO-214AC
J1: 5.5x2.1mm Barrel; POWER_JACK_SMD
J3: FEMALE 2x3; 2X3
KEYPAD: 8-Pins; 1X08_ROUND
LCD: 7-Pins; 1X07
R1: 120; 0603-RES
R2: 360; 0603-RES
R3: 2k2; 0603-RES
R4: 1k; 0603-RES
SERVO: 3-Pins; 1X03
SOLENOID: 2-Pins; 1X02
T1: TIP31; TO220
TOGGLE: 2-Pins; 1X02
U1: ATMEGA328P_PDIP; DIL28-3
V_REG: LD117AS12TR; SOT223

Connections:
DATA1: LCD.1, U1.6 (PD4(XCK/T0))
DATA2: LCD.2, U1.11 (PD5(T1))
DATA3: LCD.3, U1.12 (PD6(AIN0))
DATA4: LCD.4, U1.13 (PD7(AIN1))
EN: LCD.7, U1.2 (PD0(RXD))
GND: C1.2, C2.2, C3.2, C4.2, C5.2, J1.GND (GNDBREAK), J1.P$4 (GND), J3.6, R2.1, R4.1, SERVO.3, T1.3 (E), U1.8 (GND), U1.22 (GND)
KEY1: KEYPAD.1, U1.15 (PB1(OC1A))
KEY2: KEYPAD.2, U1.16 (PB2(SS/OC1B))
KEY3: KEYPAD.3, U1.23 (PC0(ADC0))
KEY4: KEYPAD.4, U1.24 (PC1(ADC1))
KEY5: KEYPAD.5, U1.25 (PC2(ADC2))
KEY6: KEYPAD.6, U1.26 (PC3(ADC3))
KEY7: KEYPAD.7, U1.27 (PC4(ADC4/SDA))
KEY8: KEYPAD.8, U1.28 (PC5(ADC5/SCL))
MISO: J3.1, U1.18 (PB4(MISO))
MOSI: J3.4, U1.17 (PB3(MOSI/OC2))
MOTOR: SERVO.2, U1.5 (PD3(INT1))
unnamed: R3.2, T1.1 (B)
unnamed: C1.1, R1.1, R2.2, V_REG.1 (ADJ)
RESET: J3.5, U1.1 (PC6(/RESET))
RS: LCD.6, U1.4 (PD2(INT0))
SCK: J3.3, U1.19 (PB5(SCK))
SOLENOID: R3.1, U1.10 (PB7(XTAL2/TOSC2))
SOLENOID-: D2.A, SOLENOID.2, T1.2 (C)
SWITCH: R4.2, TOGGLE.2, U1.9 (PB6(XTAL1/TOSC1))
VCC: C2.1, C3.1, C4.1, C5.1, D1.A, D2.C, J3.2, R1.2, SERVO.1, SOLENOID.1, TOGGLE.1, U1.7 (VCC), U1.20 (AVCC), V_REG.4 (OUT)
VIN: D1.C, J1.VIN0 (PWR), V_REG.3 (IN)
W/R: LCD.5, U1.3 (PD1(TXD))

Notes on the sheet:
VCC = 5V
Solenoid Mechanism
Moving Arm
ISP Pins
Toggle Switch
Headers
Power Supply

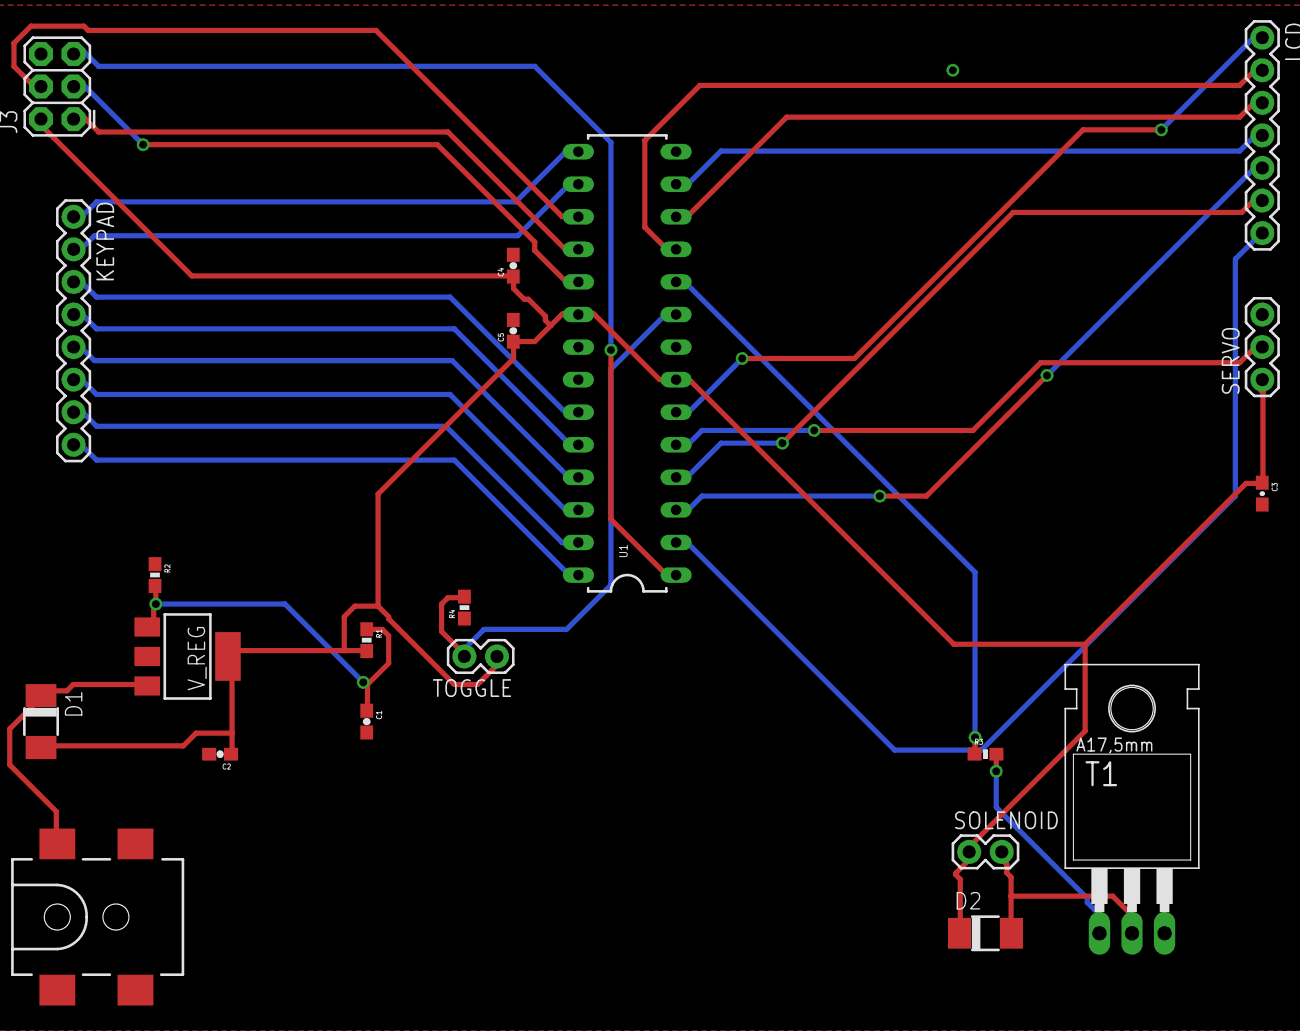
[picture p49: board T09_LockBox_ver4.brd from above]

Board: 2 copper layers, 21 parts (0 on the bottom side), 28 nets.
