dandz12/ECE411-Practicum-Project/full_build.cpp

/*
 * Full_build.cpp
 *
 * Created: 11/21/2016 2:55:00 PM
 * Author : dandiaz
 */ 

#define F_CPU 1000000UL							// Defines CPU I/O speed
#define length 4

#define MOTOR_ON      PORTD |= (1 << PORTD3)		// Writes high to pin D3, used in PWM_Init() function
#define MOTOR_OFF     PORTD &= ~(1 << PORTD3)	// Writes low to pin D3, used in PWM_Init() function

#define ctrl PORTD				//4 bits data line = D7-D4 of MCU
#define en 0                    //enable signal = D0 of MCU
#define rs 1                    //register select signal = D2 of MCU


#include <avr/io.h>
#include <avr/interrupt.h>						// AVR interrupts header file
#include <util/delay.h>
#include <avr/wdt.h>

//global definition of our code
int code[length] = {1, 2, 3, 4};
int reset[length] = {9, 9, 9, 9};

int getkey(void);						//OK
void blink(int);						//OK
void unlock(void);						//OK
void PWM_Init(void);					//OK

void lcd_ini(void);						//initialize LCD											//CHecked
void LCD_cmd(unsigned char cmd);		//send 4bits command in 4bits mode (half of a command)		//fine
void LCD_write(unsigned char data);		//send 4bits data in 4bits mode (half of a 8 bit data)		//fine
void dis_cmd(char);						//send full 8bits command in 4bits mode						//fine, 1ms delay,
void dis_data(char);					//send full 8bits data in 4bits mode						//fine, 1ms delay,
void LCD_write_string(char *str);																	//make sure that we don't put -1 here

int isEqual(int a[], int b[], int n);	//compare two arrays that have same length, 1 = equal, 0 = not equal		//OK
void promptKey(int *array);				//prompt Key, array is a integer array length of 4							//
void changePasscode (int *passcode);		//reset sequence to change passcode
int isNumber(int *array, int N);

int main(void)
{
	int codeIn[length];

	sei();					//enable interrupts
	//DDRD |= (1 << DDD3);
	DDRB |= (1 << DDB7);
	
	DDRD = 0xFF;					//Set Port D as output 
	
	//setup our ports
	DDRC = 0x3C;
	//DDRB = 0x00;
	PORTC = 0x03;		//output 5v and pull up
	PORTB = 0x30;		//output 5v and pull up
	
	_delay_ms(30);
	lcd_ini();                  //Initialization of LCD
	_delay_ms(30);              // Wait 30ms to make sure that LCD is initialized
		
		
	while (1)
	{
	if(PINB & (1 << 6))
	{
		dis_cmd(0x01);								 //0x01 = clear LCD
		_delay_ms(1);
		LCD_write_string("Enter Pass code: ");       //function to print string on LCD
		dis_cmd(0xC0);								 //enter second line
		_delay_ms(1);
			
		//check if correct code is entered;
		promptKey(codeIn);
		if(isEqual(codeIn,code,length))
		{
			unlock();
			PWM_Init();									
		}		
		//check if reset code is entered;
		else if(isEqual(codeIn,reset,length))
			changePasscode(code);
		else
		{
			dis_cmd(0x01);
			_delay_ms(1);
			LCD_write_string("Wrong!!!");
			PWM_Init();
			_delay_ms(1500);
		}
	}
		else 
		{
		dis_cmd(0x01);
		_delay_ms(1);
		LCD_write_string("Get lost!");
		_delay_ms(2000);
		dis_cmd(0x01);
		_delay_ms(1);
		}
	}
}


int getkey(void)
{
	volatile int num = 0;
	
	//loop and wait for a button
	while(1)
	{	
	while(PINB & (1<<6))
	{
		if((((PINC & 0x03) << 2) | ((PINB & 0x30) >> 4)) != 0x0F)
		{
			_delay_ms(5);					//delay to debounce
			num = (((PINC & 0x03) << 2) | ((PINB & 0x30) >> 4));	//set the bitpattern for the first part of the keypad array
			
			DDRB ^= 0x30;					//change inputs
			DDRC ^= 0x3F;					//change inputs
			_delay_ms(1);					//delay to apply change
			
			PORTB ^= 0x30;					//change output high
			PORTC ^= 0x3F;					//change output high
			_delay_ms(1);					//delay to apply change
			
			num |= (PINC << 2);				//set the bitpattern for the second part of keypad array
			
			//determine what button was pushed based on bitpattern
			switch (num & 0xFF)
			{
				case 0b11101110:
					num =1;
					break;
				case 0b11011110:
					num = 2;
					break;
				case 0b10111110:
					num = 3;
					break;
				case 0b11101101:
					num = 4;
					break;
				case 0b11011101:
					num = 5;
					break;
				case 0b10111101:
					num = 6;
					break;
				case 0b11101011:
					num = 7;
					break;
				case 0b11011011:
					num = 8;
					break;
				case 0b10111011:
					num = 9;
					break;
				case 0b11010111:
					num = 0;
					break;
				case 0b11100111:	//*
					num = -1;
					break;
				//* should change passcode
				//#should reset
				default:	//default should be reset
					num = -1;
					break;
			}

			//set the outputs back to their original state
			_delay_ms(5);
			DDRB ^= 0x30;
			DDRC ^= 0x3F;
			_delay_ms(1);
			
			PORTB ^= 0x30;
			PORTC ^= 0x3F;
			_delay_ms(500);				//we need to delay so we don't get double input
			
			return num;
		}
	}
	return -1;
	}
}

void blink(int num)
{
	for(int i = 0; i < num; i ++)
	{
		PORTD = 0x01;
		_delay_ms(10);
		PORTD = 0x00;
		_delay_ms(10);
		
	}
	
}

ISR(TIMER1_COMPA_vect)							// Interrupt service routine for OCRnA (output compare register A)
{												// On portion of the PWM cycle
	MOTOR_ON;									// Macro turns MOTOR on, defined above
}

ISR(TIMER1_COMPB_vect)							// Interrupt service routine for OCRnB (output compare register B)
{												// Off portion of the PWM cycle
	MOTOR_OFF;									// Macro turns MOTOR off, defined above
}

void PWM_Init(void)								// Function for PWM (pulse width modulation)
{
	TCCR1B |= (1 << CS10) | (1 << WGM12);		// Sets CS(clock set) prescaler to zero and WGM (wave generation mode) bits in TCCR1A (timer/counter control register)
	TIMSK1 |= (1 << OCIE1A) | (1 << OCIE1B);		// Sets OCIE1x (output compare interrupt enable) register in TIMSK1 (timer mask) register
	OCR1A =	20000;								// Sets PWM period to 20ms (50Hz) by writing to OCR1A (output compare) register with TOP value of counter
	OCR1B = 3000;								// Extend arm by writing longer pulse width to OCR1B (output compare) register
	_delay_ms(500);								// Delay to give arm enough time to flip switch before retracting
	OCR1B = 1000;								// Retract arm by writing shorter pulse width to OCR1B (output compare) register
}

void lcd_ini(void) //initialize LCD
{
	dis_cmd(0x02); //0x02 = set LCD in 4 bits mode
	_delay_ms(1);
	dis_cmd(0x28); //0x28 = 2 lines, 5x7 dots, 4 bits mode
	_delay_ms(1);
	dis_cmd(0x01); //0x01 = clear LCD
	_delay_ms(1);
	dis_cmd(0x0E); //0x0E = cursor ON
	_delay_ms(1);
	dis_cmd(0x80); //0x80 = first lines, 0th position
	_delay_ms(1);
	return;
}

void dis_cmd(char cmd_value)	//send full 8bits command in 4bits mode
{
	char cmd_value1;
	cmd_value1 = cmd_value & 0xF0;          //mask lower nibble
	//because PA4-PA7 pins are used.
	LCD_cmd(cmd_value1);					//send to LCD, use LCD_cmd
	cmd_value1 = ((cmd_value<<4) & 0xF0);   //shift 4-bit and mask the others 4
	LCD_cmd(cmd_value1);					//send to LCD, use LCD_cmd
	_delay_ms(1);
}
void dis_data(char data_value)  //send full 8bits data in 4bits mode
{
	char data_value1;
	data_value1=data_value & 0xF0;			//mask lower nibble
	LCD_write(data_value1);					//send to LCD, use LCD_write
	data_value1=((data_value<<4) & 0xF0);	//shift 4bit and mask the others 4
	LCD_write(data_value1);					//send to LCD, use LCD_write
}

void LCD_cmd(unsigned char cmd)  //send 4bits command in 4bits mode (half of a command)
{
	ctrl=cmd;					 //output the data
	ctrl&=~(1<<rs);				 //rs = high (sending command)
	ctrl|=(1<<en);				 //create falling edge in enable (set to high -> low)
	_delay_ms(1);
	ctrl&=~(1<<en);
	_delay_ms(40);
	return;
}

void LCD_write(unsigned char data) //send 4bits data in 4bits mode (half of a 8 bit data)
{
	ctrl= data;					//output the data
	ctrl|=(1<<rs);				//rs = low (sending data)
	ctrl|=(1<<en);				//create falling edge in enable (set to high -> low)
	_delay_ms(1);
	ctrl&=~(1<<en);
	_delay_ms(40);
	return ;
}

void LCD_write_string(char *str)             //store address value of the string in pointer *str
{
	int i=0;
	
	if((str[i] & 0x30) == 0x30)
		dis_data(str[i]);
	else 
	{	
		while(str[i]!='\0')                               // loop will go on till the NULL character in the string
		{
			dis_data(str[i]);                            // sending data on LCD byte by byte
			i++;
		}
	}
	return;
}

void unlock(void)
{
	PORTB ^= (1 << DDB7);
	_delay_ms(2000);
	PORTB ^= (1 << DDB7);
	_delay_ms(500);
	
}

void changePasscode (int *passcode)
{
	dis_cmd(0x01);								 //0x01 = clear LCD
	LCD_write_string("Old pass code?: ");       //function to print string on LCD
	dis_cmd(0xC0);
	int codeIn[length];
	promptKey(codeIn);
	
	if(isEqual(codeIn,code,length))	{
		dis_cmd(0x01);
		LCD_write_string("New passcode?");
		dis_cmd(0xC0);
		int codeNew[length];
		promptKey(codeNew);
		for (int i = 0; i < length; i++)
		code[i] = codeNew[i];
		
		dis_cmd(0x01);
	}
	else{
		dis_cmd(0x01);
		LCD_write_string("Wrong code ...");
		_delay_ms(1000);
	}
}

int isEqual(int a[], int b[], int n)
{
	int tmp = 1;
	for (int i = 0; i < n; i++)
	if (a[i] != b[i]) tmp = 0;
	return tmp;
}



void promptKey(int *array)
{
	for (int i = 0; i < length; i++)
	{
		array[i] = getkey();
		if(array[i] == -1)
			return;
		dis_data((char) array[i] ^ 0x30);
		
	}
	
	while (!isNumber(array,length))
	{
		dis_cmd(0x01);
		LCD_write_string("enter a NUMBER:");
		dis_cmd(0xC0);		
			for (int i = 0; i < length; i++)
			{
				array[i] = getkey();
				dis_data((char) array[i] ^ 0x30);
			}
	}
}

int isNumber(int *array, int N)
{
	int tmp = 1;
	for (int i = 0; i < length; i++)
	{
		if ((array[i]<0)|(array[i]>9))
		{
			tmp = 0;
		}
	}
	return tmp;
}
