dandz12/ECE411-Practicum-Project/(commit log)

2016-10-08 Add files via upload
    Dwayne added info into the decision matrix
    [Copy of Decision Matrix.xlsx]
2016-10-08 Revert "Revert "Merge pull request #5 from dandz12/Ha's-branch""
    This reverts commit 9b01ece93a4c787b3d0d3d6b80cd6086ba08118c.
    [Copy of Decision Matrix.xlsx, Decision Matrix.xlsx, Dwayne & Ha & Danial Decision Matrix.xlsx]
2016-10-17 Sample blinking LED code
    I finally got some results in using my Arduino to program the stand-alone ATmega328 with no Arduino bootloader!!! The code below is C code that I just pasted into the Arduino IDE, and it understands it! The only issue is that the timing seems off.
    If I set the timer to 100ms, for example, it actually blinks about once every 1.5 seconds. I suspect it has something to do with
    defining the clock speed of the chip, but I am not sure.
2016-10-20 Fixing the toggle switch connect to the microprocessor
2016-10-24 LCD writing words sample code
2016-11-01 Voltage regulator datasheet
2016-11-03 LockBox Ver2 No ERC errors
    [LockBox_ver2.sch]
2016-11-03 Add files via upload
    Code for the microcontroller to read the keypad and blink an LED.
2016-11-04 Updated Project
    I added the switch task to the project
2016-11-04 Add files via upload
    This file is still testing the keypad with an LED but is written for our final design.
2016-11-06 Final Version of Schematic with block names, bypass caps, ect.
    [T09_LockBox-Schematic_ver3.sch]
2016-11-06 Add files via upload
    I added some specifics about who will be designing and manufacturing the box and arm.
2016-11-10 Updated schematic with layout, no DRC errors (read extended description)
    http://docs.oshpark.com/design-tools/eagle/.
    You can ignore DRU errors on the tStop and bStop layers since we automatically prevent silk from being placed on exposed copper.
    [T09_LockBox-PCBLayout_ver4.sch.brd, T09_LockBox-Schematic_ver4.sch.sch]
2016-11-10 Delete T09_LockBox-Schematic_ver4.sch.sch
    Wrong upload
    [T09_LockBox-Schematic_ver4.sch.sch]
2016-11-10 Delete T09_LockBox-PCBLayout_ver4.sch.brd
    Wrong updload
    [T09_LockBox-PCBLayout_ver4.sch.brd]
2016-11-10 Updated schematic with layout, no DRC error (read extended description)
    http://docs.oshpark.com/design-tools/eagle/
    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
    [T09_LockBox_ver4.brd, T09_LockBox_ver4.sch]
2016-11-10 Servo Code
    This pastes much more neatly in Atmel Studio, sorry this is kind of a mess and difficult to read.
2016-11-12 Updated servo code
    Sorry it took me so long to get this updated and uploaded.
2016-11-15 4 bit communication with LCD code with Hello World example
    Example code for printing Hello World in 2 lines
    DDRD=0xFF; // Set port D as output
    lcd_ini(); // initialization of LCD
    LCD_write_string("hello"); // function to print string on LCD
    dis_cmd(0xC0); // move to second line
    LCD_write_string("world"); // function to print string on LCD
2016-11-17 LockBox-ver5 after Prof.Andrew's Comment
    [T09_LockBox_ver5.sch]
2016-11-17 Layout after Prof.Andrew's comment _ Still need to check again one more time tomorrow before submitting
    [T09_LockBox_ver5.brd]
2016-11-17 Final Version of Schematic and Layout
    [T09_LockBox_ver6.brd, T09_LockBox_ver6.sch]
2016-11-17 Add files via upload
    Keypad using the new pin assignments
2016-11-19 Update LCD codes (details in extended description)
    Frequency defined = 1MHz
    Clear warning errors while compiling.
    [LCD_4bits.c]
2016-11-20 Final fixed-all Schematic
    [T09_LockBox_ver5.0.sch]
2016-11-20 Final fixed-all Schematic - Uploaded file
    [T09_LockBox_ver5.0.brd]
2016-11-20 BOM and List of websites to buy
2016-11-22 First full build
    This build has the keypad, screen, servo and solenoid together.
2016-12-02 Change control pins according to the board layout
    Old pin in prototype: RS is D2
    New pin in PCB board: RS is D1
2016-12-03 Update useful link
    with PWM information
2016-12-07 Added switch
    Todo: clear screen when switch is flipped back
    [full_build.cpp]
2016-12-07 Finished switch to print
    Almost final, needs some cleaning
2016-12-08 Update full_build.cpp
    Slow the LCD cmd again, due to bug
    [full_build.cpp]
2016-12-08 Box SOLIDWORK
    [Back.SLDPRT, Bottom.SLDPRT, Bottom_Top2_Door.SLDDRW, Door.SLDPRT, Front1.SLDPRT, Front2.SLDPRT, LockBox.SLDASM, Side.SLDPRT]
2016-12-08 Final Presentation update
    [Total Unit Cost.xlsx]
